hannahgruene/T3_3100-Studienarbeit_I/README.md

# T3_3100-Studienarbeit_I

Der Bericht der Studienarbeit ist unter dem Namen "Grüne_Hannah_Design und Entwicklung eines smarten Bewässerungssystems für Pflanzen.pdf" abgelegt.

Der finale Code für das Pflanzenbewässerungssystem, die zugehörige JSON-Datei und die Beispiel-JSON-Datei liegen im Ordner /Pflanzenbewaesserungssystem_Hannah_Gruene ab.

Für die Messwertgrenzen sind die txt-Dateien, das Testprogramm und der python-Code im Ordner /Messprogramm_Sensorgrenzen abgelegt.

Die Funktionstests für das Auslesen der SD-Karte, RTC und der Sensorwerte sind in der Schaltplan-Testprogramm.ino Datei.
